t-yunqi/cde2310_g4/software_doc/rpi_code/README.md

# RPI LAUNCH STACK

### before getting started you should make sure that you have followed the setup guide for your rpi in the [turtlebot setup guide](https://emanual.robotis.com/docs/en/platform/turtlebot3/sbc_setup/#sbc-setup)

#### please note that for the rpi camera setup, follow the v4l2 instructions

additionally, for image nodes for usb cameras

> sudo apt-get install ros-humble-usb-cam v4l-utils

### this repository includes the launch files for:
 - #### Camera Image Node
 - #### Aruco Detection Node
 - #### Camera to baselink tf static transform files

<br></br>
## setup [ON RPI]
```bash
1. sudo apt install ros-humble-cv-bridge ros-humble-image-geometry ros-humble-tf2-ros ros-humble-tf-transformations ros-humble-sensor-msgs ros-humble-geometry-msgs
2. mkdir launchfiles && cd launchfiles
3. git clone --branch rpi_code --single-branch https://github.com/ChinYanXu/CDE2310_g4_AY2526_turtlebot_ROS2.git
4. rosdep update
5. rosdep install --from-paths src --ignore-src -r -y
6. pip3 install opencv-contrib-python transforms3d 
7. pip install empy==3.3.4 catkin-pkg==1.1.0 lark==1.1.1
8. colcon build
9. source install/setup.bash
10. chmod +x one.sh
```
#### check that numpy version is 1.26.4, 

```
python3 -c "import numpy; print(numpy.__version__)"
```
###### if it isnt, install numpy version 1.26.4
```
pip uninstall numpy -y
pip install numpy==1.26.4
```

### camera calibration
---
#### You should follow [this guide](https://docs.ros.org/en/kilted/p/camera_calibration/doc/tutorial_mono.html) to obtain your camera calibration files
launch camera image nodes 
```
#list all camera devices and remember it
1. v4l2-ctl --list-devices
#edit launch file parameters
nano cam_launch.py    #->change the camera directories in lines 10 and 16 
```

#### move camera calibration files to correct destination
```
1. cp <camera_calibration yaml file location>/* ~/.ros/camera_info
```
###### **_do take note that the camera resolution during operation and calibration has to be the same_**

### Customization
---
#### you may customize the type and size of the physical aruco tag, but you will have to modify the values in the [launch file](camult.py) 
##### also change the lines in [camult.py](camult.py) labelled critical 

## launch all files
```
1. cd ~/launchfiles
2. ./one.sh rpi
``` 

## Additional Notes
#### For all nodes using the cam_left namespace, in the physical bot, the video feed comes from the bottom camera; 
#### nodes using the cam_right namespace correspond to the top camera.

## For debugging
#### You can view the bounding boxes created by the aruco node from your computer by using the GUI_OVERLAY.py program.
#### on your computer, go to the [pc_code directory](../pc_code/), and run
`python3 GUI_OVERLAY.py --camera cam_right/cam_left`   

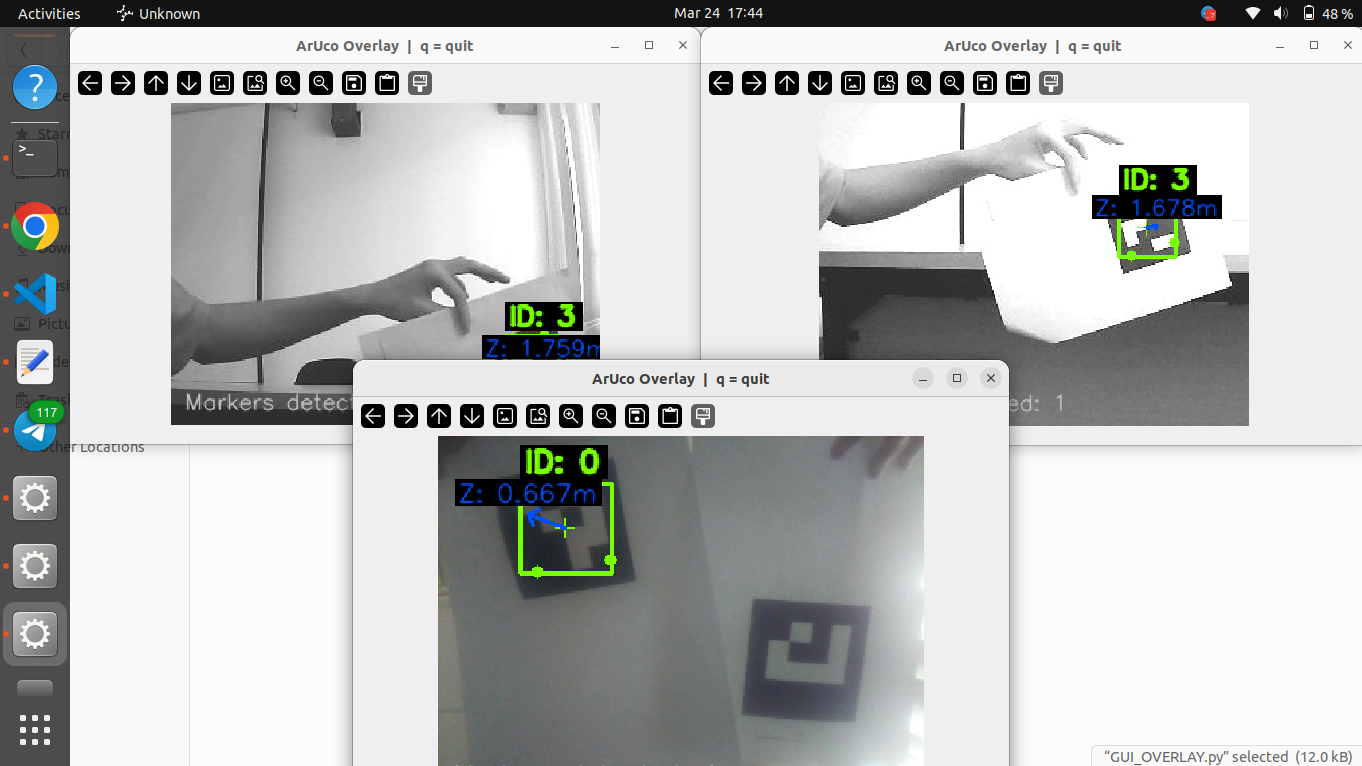
[picture p2: images/GUI_OVERLAY.png]
visualisation
