t-yunqi/cde2310_g4/docs/turtlebot_w_ramp_labelled.jpg

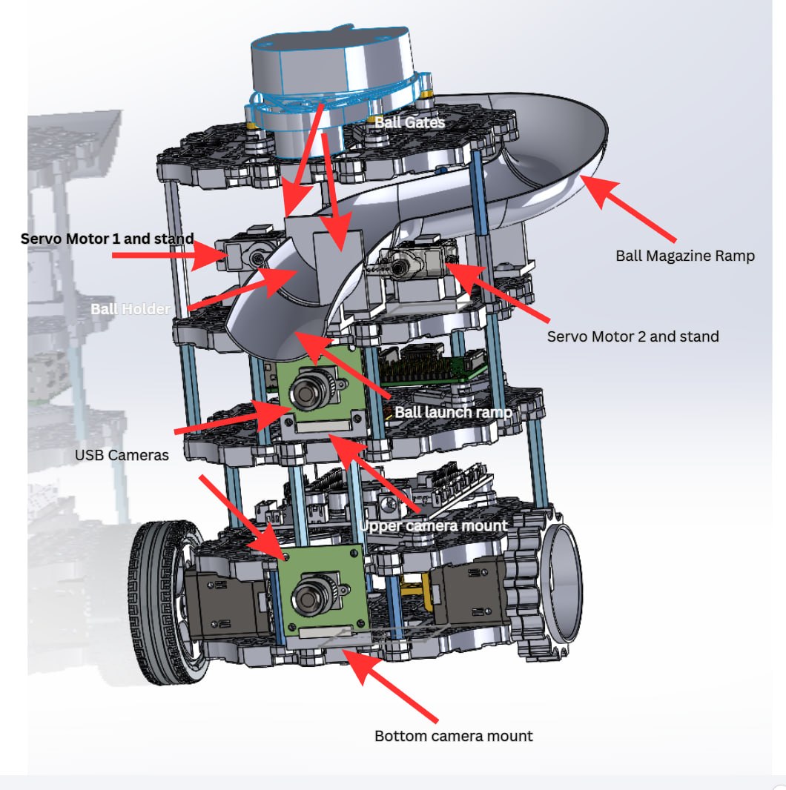
docs/turtlebot_w_ramp_labelled.jpg
