t-yunqi/cde2310_g4/docs/turtlebot_w_ramp_unlabelled.jpg

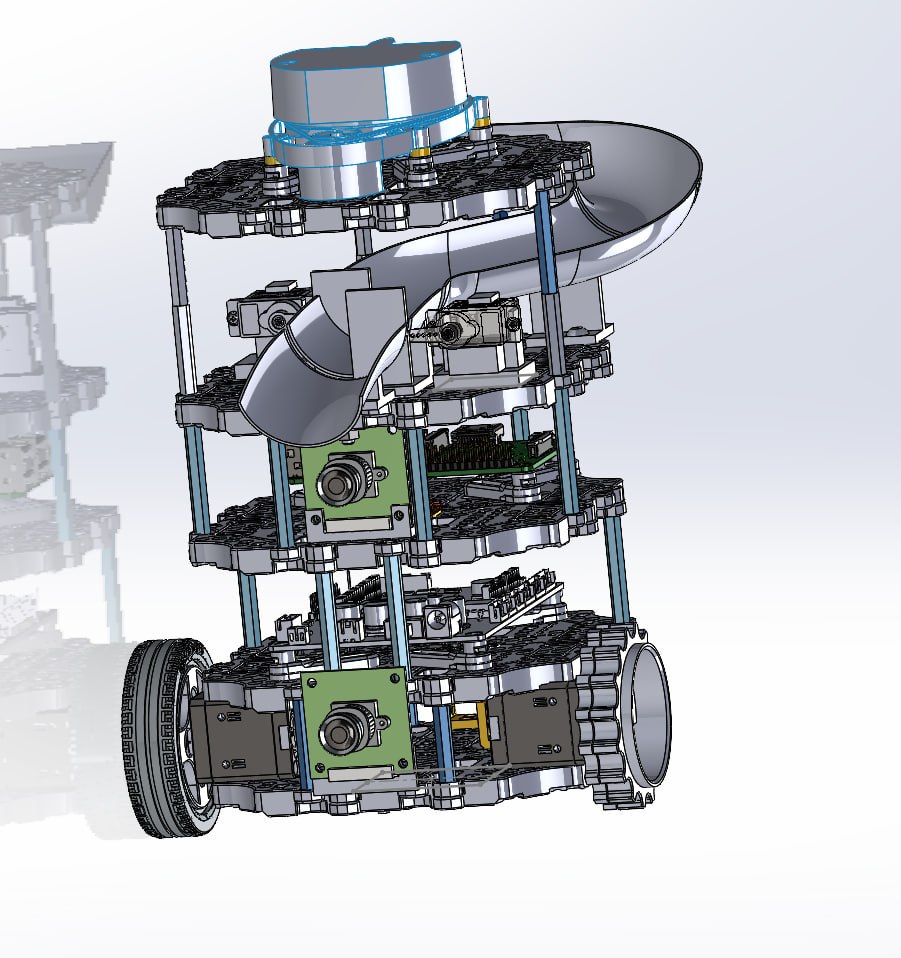
docs/turtlebot_w_ramp_unlabelled.jpg
