t-yunqi/cde2310_g4/images/final_version.png

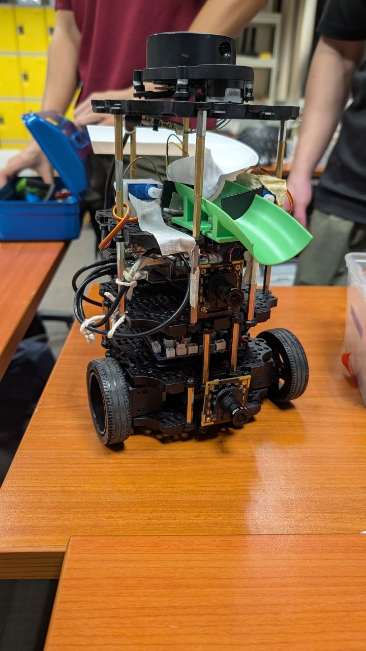
images/final_version.png
