t-yunqi/cde2310_g4/(commit log)

2026-03-19 Added new custom map because old map is too sparse. Debugging simulation pipeline
    [custom_maze_CDE2310_old.sdf]
2026-03-25 Add scaled custom maze and launch file
    [custom_maze_CDE2310.sdf, custom_maze_CDE2310_old2.sdf, model.sdf]
2026-03-27 camera tf transformations launch file, values need to be changed
2026-03-31 changed aruco node py to publish tf, camera frame baselink launchfile to broadcast the thing
2026-04-18 RPI CAMERA LAUNCH AND PAYLOAD LAUNCH FILES
    [custom_maze_CDE2310.sdf, custom_maze_CDE2310_old.sdf, custom_maze_CDE2310_old2.sdf, model.sdf]
2026-04-18 Reorganise repo
    [custom_maze_CDE2310.sdf, custom_maze_CDE2310_old.sdf, custom_maze_CDE2310_old2.sdf, model.sdf]
2026-04-18 organised folders
    [custom_maze_CDE2310.sdf, custom_maze_CDE2310_old.sdf, custom_maze_CDE2310_old2.sdf, model.sdf]
2026-04-19 renamed to software_doc
    [custom_maze_CDE2310.sdf, custom_maze_CDE2310_old.sdf, custom_maze_CDE2310_old2.sdf, model.sdf]
2026-04-19 Add camera visualisation instructions
